Tobias66662/Bachelor-Project-Enose-PCB/Enose_PCB/Enose_PCB.kicad_pcb

## KiCad design Enose_PCB/Enose_PCB.kicad_pcb (2026-04-17)

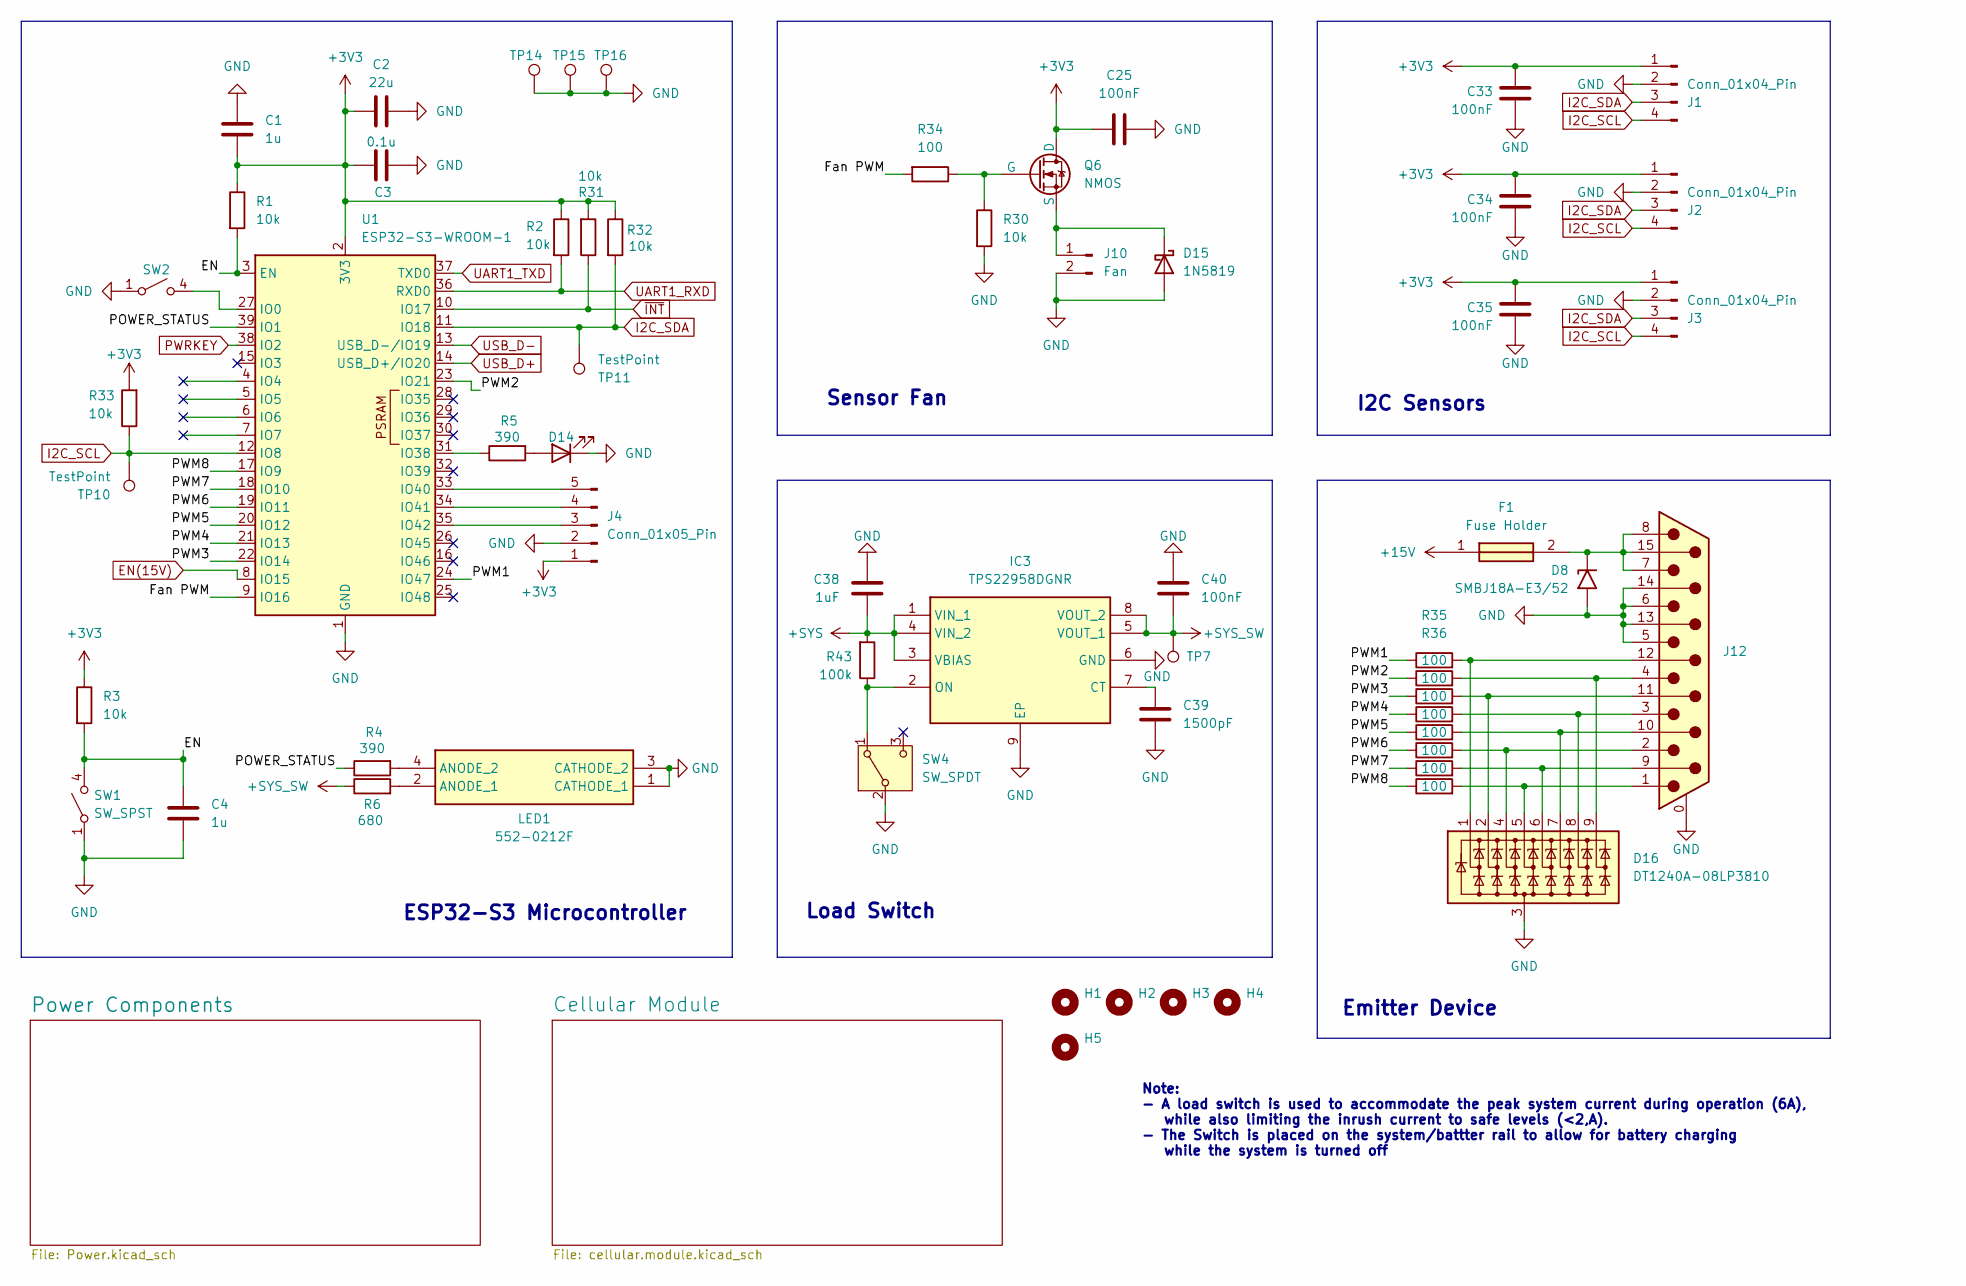
[picture p1: schematic Enose_PCB.kicad_sch]

Parts:
C1, C4: 1u; C_0805_2012Metric_Pad1.18x1.45mm_HandSolder
C2: 22u; C_0805_2012Metric_Pad1.18x1.45mm_HandSolder
C3: 0.1u; C_0805_2012Metric_Pad1.18x1.45mm_HandSolder
C25, C33, C34, C35, C40: 100nF; C_0805_2012Metric_Pad1.18x1.45mm_HandSolder
C38: 1uF; C_0805_2012Metric_Pad1.18x1.45mm_HandSolder
C39: 1500pF; C_0805_2012Metric_Pad1.18x1.45mm_HandSolder
D8: SMBJ18A-E3/52; D_SMB
D14: LED Amber; LED_0805_2012Metric_Pad1.15x1.40mm_HandSolder
D15: 1N5819; D_SOD-123
D16: DT1240A-08LP3810; UDFN-9_1.0x3.8mm_P0.5mm
F1: Fuse Holder; 64600001223; Mouser Part Number 576-64600001223
H1, H2, H3, H4, H5: MountingHole; MountingHole_3.2mm_M3
IC3: TPS22958DGNR; SOP65P490X110-9N; Mouser Part Number 595-TPS22958DGNR
J1: Conn_01x04_Pin; PinHeader_1x04_P2.54mm_Vertical
J2, J3: Conn_01x04_Pin; JST_XH_B4B-XH-A_1x04_P2.50mm_Vertical
J4: Conn_01x05_Pin; PinHeader_1x05_P2.54mm_Vertical
J10: Fan; JST_XH_B2B-XH-AM_1x02_P2.50mm_Vertical
J12: DA15_Pins_MountingHoles; 6E17C015PAJ121
LED1: 552-0212F; 5520212F; Mouser Part Number 645-552-0212F
Q6: NMOS; SOT-23-3
R1, R2, R3, R30, R31, R32, R33: 10k; R_0805_2012Metric_Pad1.20x1.40mm_HandSolder
R4, R5: 390; R_0805_2012Metric_Pad1.20x1.40mm_HandSolder
R6: 680; R_0805_2012Metric_Pad1.20x1.40mm_HandSolder
R34, R35, R36, R37, R38, R39, R40, R41, R42: 100; R_0805_2012Metric_Pad1.20x1.40mm_HandSolder
R43: 100k; R_0805_2012Metric_Pad1.20x1.40mm_HandSolder
SW1, SW2: SW_SPST; 430181038816
SW4: SW_SPDT; OS102011MA1QN1
TP7, TP10, TP11, TP14, TP15, TP16: TestPoint; TestPoint_Pad_D1.5mm
U1: ESP32-S3-WROOM-1

Connections:
+3V3: C1.1, C2.1, C3.2, C25.2, C33.1, C34.1, C35.1, J1.1, J2.1, J3.1, J4.1, Q6.1 (D), R1.1, R2.1, R3.1, R31.2, R32.1, R33.2, U1.2 (3V3); also elsewhere on the board
+15V: F1.1; also elsewhere on the board
+SYS: C38.2, IC3.1 (VIN_1), IC3.3 (VBIAS), IC3.4 (VIN_2), R43.2; also elsewhere on the board
+SYS_SW: C40.2, IC3.5 (VOUT_1), IC3.8 (VOUT_2), R6.1, TP7.1; also elsewhere on the board
/EN: C4.1, R1.2, R3.2, SW1.4 (B), U1.3 (EN)
/Fan PWM: R34.2, U1.9 (IO16)
/POWER_STATUS: R4.1, U1.39 (IO1)
/PWM1: R35.1, U1.24 (IO47)
/PWM2: R36.1, U1.23 (IO21)
/PWM3: R37.1, U1.22 (IO14)
/PWM4: R38.1, U1.21 (IO13)
/PWM5: R39.1, U1.20 (IO12)
/PWM6: R40.1, U1.19 (IO11)
/PWM7: R41.1, U1.18 (IO10)
/PWM8: R42.1, U1.17 (IO9)
EN(15V): U1.8 (IO15); also elsewhere on the board
GND: C1.2, C2.2, C3.1, C4.2, C25.1, C33.2, C34.2, C35.2, C38.1, C39.2, C40.1, D8.2 (A2), D14.1 (K), D15.2 (A), D16.3 (A), IC3.6 (GND), IC3.9 (EP), J1.2, J2.2, J3.2, J4.2, J10.2, J12.0 (PAD), J12.5, J12.6, J12.13, J12.14, LED1.1 (CATHODE_1), LED1.3 (CATHODE_2), R30.2, SW1.1 (A), SW2.1 (A), SW4.2 (B), TP14.1, TP15.1, TP16.1, U1.1 (GND), U1.40 (GND), U1.41 (GND); also elsewhere on the board
I2C_SCL: J1.4, J2.4, J3.4, R33.1, TP10.1, U1.12 (IO8); also elsewhere on the board
I2C_SDA: J1.3, J2.3, J3.3, R32.2, TP11.1, U1.11 (IO18); also elsewhere on the board
unnamed: D8.1 (A1), F1.2, J12.7, J12.8, J12.15
unnamed: D14.2 (A), R5.2
unnamed: D15.1 (K), J10.1, Q6.3 (S)
unnamed: D16.1 (K1), J12.12, R35.2
unnamed: D16.2 (K2), J12.11 (P111), R37.2
unnamed: D16.4 (K3), J12.2, R40.2
unnamed: D16.5 (K4), J12.1, R42.2
unnamed: D16.6 (K5), J12.9, R41.2
unnamed: D16.7 (K6), J12.10, R39.2
unnamed: D16.8 (K7), J12.3, R38.2
unnamed: D16.9 (K8), J12.4, R36.2
unnamed: C39.1, IC3.7 (CT)
unnamed: IC3.2 (ON), R43.1, SW4.1 (A)
unnamed: J4.3, U1.35 (IO42)
unnamed: J4.4, U1.34 (IO41)
unnamed: J4.5, U1.33 (IO40)
unnamed: LED1.2 (ANODE_1), R6.2
unnamed: LED1.4 (ANODE_2), R4.2
unnamed: Q6.2 (G), R30.1, R34.1
unnamed: SW2.4 (B), U1.27 (IO0)
unnamed: R5.1, U1.31 (IO38)
PWRKEY: U1.38 (IO2); also elsewhere on the board
UART1_RXD: R2.2, U1.36 (RXD0); also elsewhere on the board
UART1_TXD: U1.37 (TXD0); also elsewhere on the board
USB_D+: U1.14 (USB_D+/IO20); also elsewhere on the board
USB_D-: U1.13 (USB_D-/IO19); also elsewhere on the board
~INT: R31.1, U1.10 (IO17); also elsewhere on the board

Notes on the sheet:
Note: - A load switch is used to accommodate the peak system current during operation (6A), while also limiting the inrush current to safe levels (<2,A). - The Switch is placed on the system/battter rail to allow for battery charging while the system is turned off
ESP32-S3 Microcontroller
Emitter Device
Load Switch
I2C Sensors
Sensor Fan

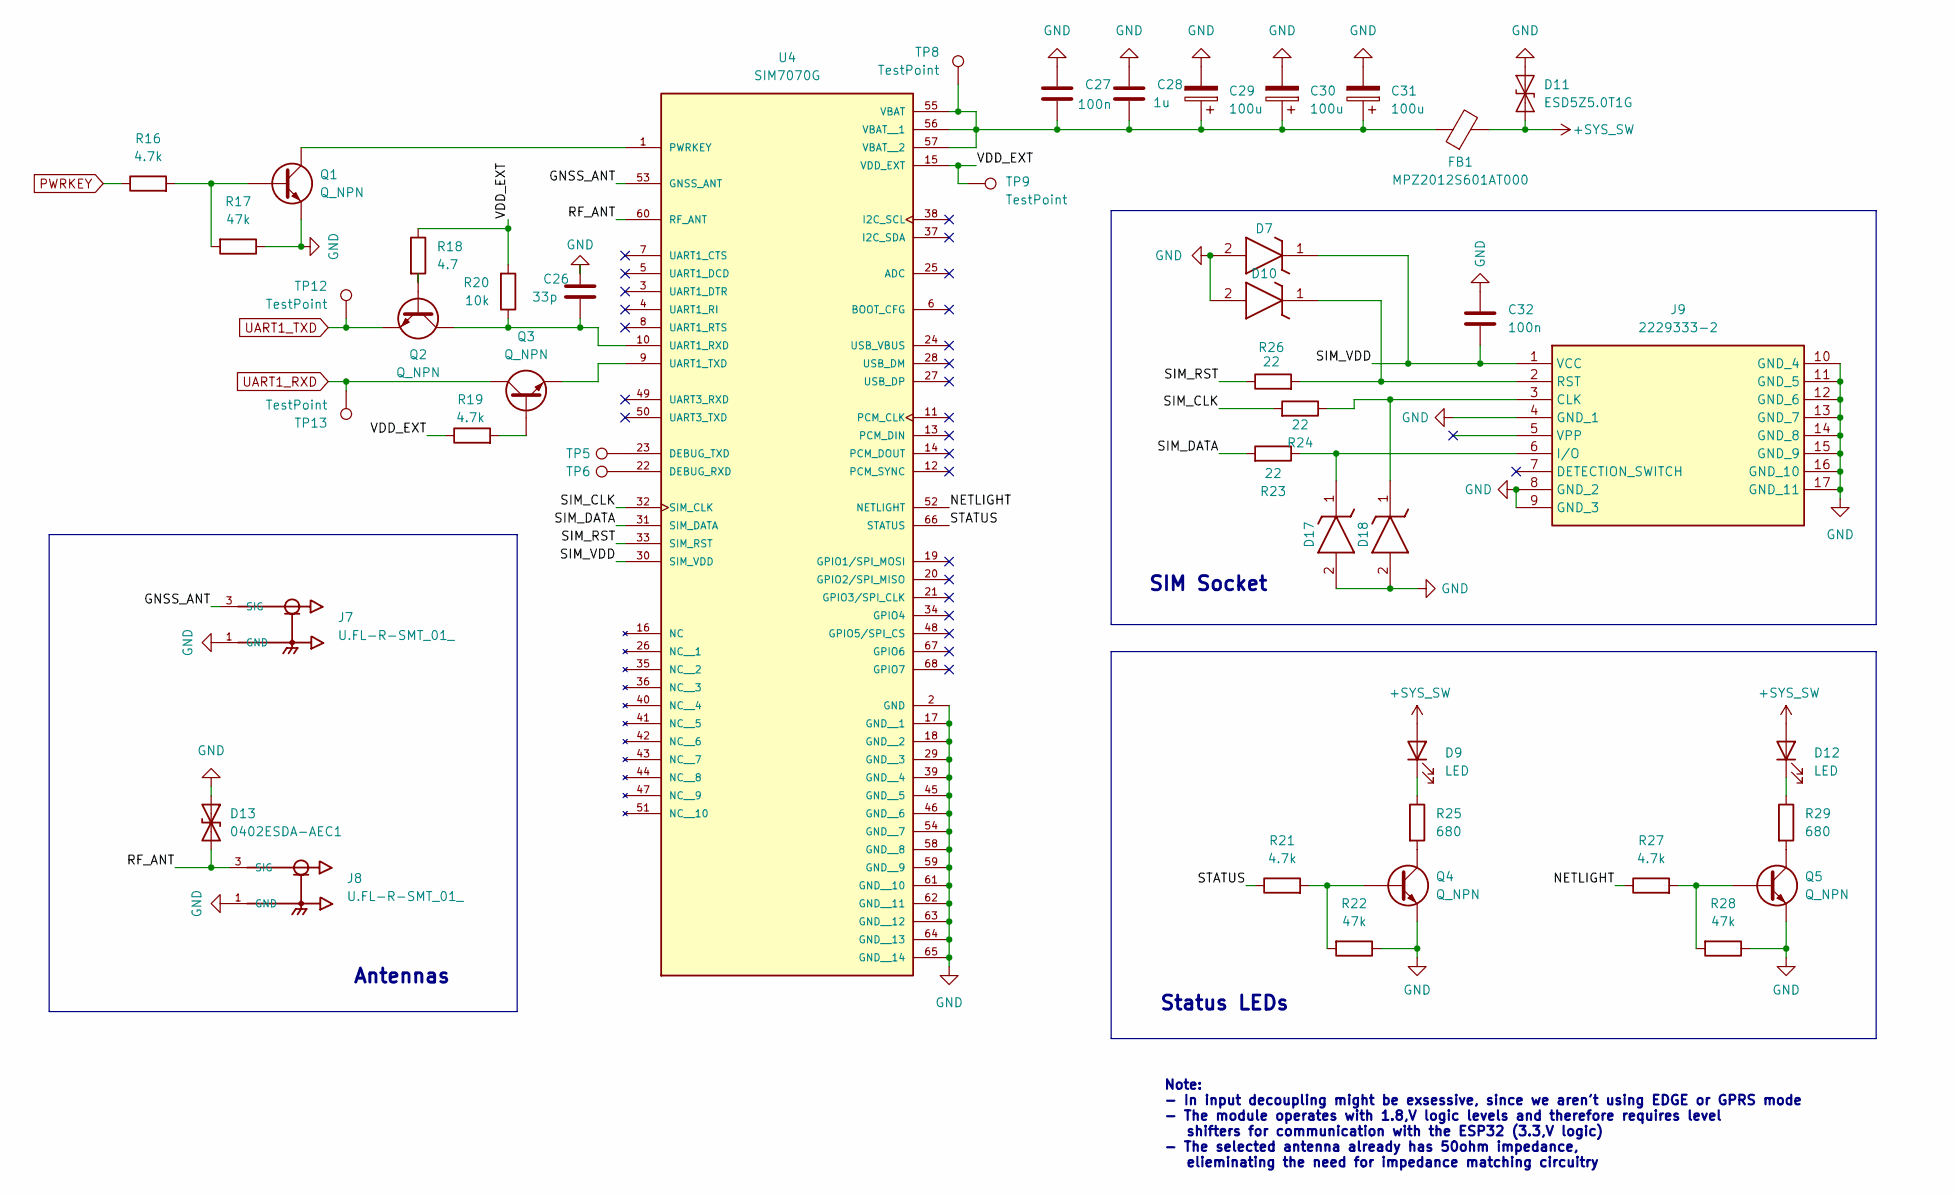
[picture p2: schematic cellular.module.kicad_sch]

Parts:
C26: 33p; C_0603_1608Metric_Pad1.08x0.95mm_HandSolder
C27, C32: 100n; C_0805_2012Metric_Pad1.18x1.45mm_HandSolder
C28: 1u; C_0805_2012Metric_Pad1.18x1.45mm_HandSolder
C29, C30, C31: 100u; CAPAE530X610N
D7, D10, D17, D18: ESD8351XV2T1G; SODFL1608X70N; Mouser Part Number 863-ESD8351XV2T1G
D9, D12: LED; LED_0805_2012Metric_Pad1.15x1.40mm_HandSolder
D11: ESD5Z5.0T1G; D_SOD-523
D13: 0402ESDA-AEC1; 0402ESDAAEC1
FB1: MPZ2012S601AT000; L_0805_2012Metric_Pad1.05x1.20mm_HandSolder
J7, J8: U.FL-R-SMT_01_; HRS_U.FL-R-SMT_01_
J9: 2229333-2; 22293332; Mouser Part Number 571-2229333-2
Q1, Q2, Q3, Q4, Q5: Q_NPN; SOT96P237X111-3N
R16, R19, R21, R27: 4.7k; R_0805_2012Metric_Pad1.20x1.40mm_HandSolder
R17, R22, R28: 47k; R_0805_2012Metric_Pad1.20x1.40mm_HandSolder
R18: 4.7; R_0805_2012Metric_Pad1.20x1.40mm_HandSolder
R20: 10k; R_0805_2012Metric_Pad1.20x1.40mm_HandSolder
R23, R24, R26: 22; R_0805_2012Metric_Pad1.20x1.40mm_HandSolder
R25, R29: 680; R_0805_2012Metric_Pad1.20x1.40mm_HandSolder
TP5, TP6, TP8, TP9, TP12, TP13: TestPoint; TestPoint_Pad_D1.5mm
U4: SIM7070G; MODULE_SIM7070G; PARTREV V1.03

Connections:
+SYS_SW: D9.2 (A), D11.1 (A1), D12.2 (A), FB1.2; also elsewhere on the board
/Cellular Module/GNSS_ANT: J7.3 (SIG), U4.53 (GNSS_ANT)
/Cellular Module/NETLIGHT: R27.1, U4.52 (NETLIGHT)
/Cellular Module/RF_ANT: D13.2 (A2), J8.3 (SIG), U4.60 (RF_ANT)
/Cellular Module/SIM_CLK: R24.2, U4.32 (SIM_CLK)
/Cellular Module/SIM_DATA: R23.2, U4.31 (SIM_DATA)
/Cellular Module/SIM_RST: R26.1, U4.33 (SIM_RST)
/Cellular Module/SIM_VDD: C32.2, D7.1 (K), J9.1 (VCC), U4.30 (SIM_VDD)
/Cellular Module/STATUS: R21.1, U4.66 (STATUS)
/Cellular Module/VDD_EXT: R18.1, R19.1, R20.2, TP9.1, U4.15 (VDD_EXT)
GND: C26.1, C27.1, C28.1, C29.2, C30.2, C31.2, C32.1, D7.2 (A), D10.2 (A), D11.2 (A2), D13.1 (A1), D17.2 (A), D18.2 (A), J7.1 (GND), J7.2 (GND), J8.1 (GND), J8.2 (GND), J9.4 (GND_1), J9.8 (GND_2), J9.9 (GND_3), J9.10 (GND_4), J9.11 (GND_5), J9.12 (GND_6), J9.13 (GND_7), J9.14 (GND_8), J9.15 (GND_9), J9.16 (GND_10), J9.17 (GND_11), Q1.2 (E), Q4.2 (E), Q5.2 (E), R17.1, R22.1, R28.1, U4.2 (GND), U4.17 (GND__1), U4.18 (GND__2), U4.29 (GND__3), U4.39 (GND__4), U4.45 (GND__5), U4.46 (GND__6), U4.54 (GND__7), U4.58 (GND__8), U4.59 (GND__9), U4.61 (GND__10), U4.62 (GND__11), U4.63 (GND__12), U4.64 (GND__13), U4.65 (GND__14); also elsewhere on the board
unnamed: D9.1 (K), R25.1
unnamed: D10.1 (K), J9.2 (RST), R26.2
unnamed: D12.1 (K), R29.1
unnamed: D17.1 (K), J9.6 (I/O), R23.1
unnamed: D18.1 (K), J9.3 (CLK), R24.1
unnamed: Q1.1 (B), R16.2, R17.2
unnamed: Q1.3 (C), U4.1 (PWRKEY)
unnamed: Q2.1 (B), R18.2
unnamed: C26.2, Q2.3 (C), R20.1, U4.10 (UART1_RXD)
unnamed: Q3.1 (B), R19.2
unnamed: Q3.2 (E), U4.9 (UART1_TXD)
unnamed: Q4.1 (B), R21.2, R22.2
unnamed: Q4.3 (C), R25.2
unnamed: Q5.1 (B), R27.2, R28.2
unnamed: Q5.3 (C), R29.2
unnamed: TP6.1, U4.22 (DEBUG_RXD)
unnamed: TP5.1, U4.23 (DEBUG_TXD)
unnamed: C27.2, C28.2, C29.1, C30.1, C31.1, FB1.1, TP8.1, U4.55 (VBAT), U4.56 (VBAT__1), U4.57 (VBAT__2)
PWRKEY: R16.1; also elsewhere on the board
UART1_RXD: Q3.3 (C), TP13.1; also elsewhere on the board
UART1_TXD: Q2.2 (E), TP12.1; also elsewhere on the board

Notes on the sheet:
SIM Socket
Status LEDs
Antennas
Note: - In input decoupling might be exsessive, since we aren't using EDGE or GPRS mode - The module operates with 1.8,V logic levels and therefore requires level shifters for communication with the ESP32 (3.3,V logic) - The selected antenna already has 50ohm impedance, elieminating the need for im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

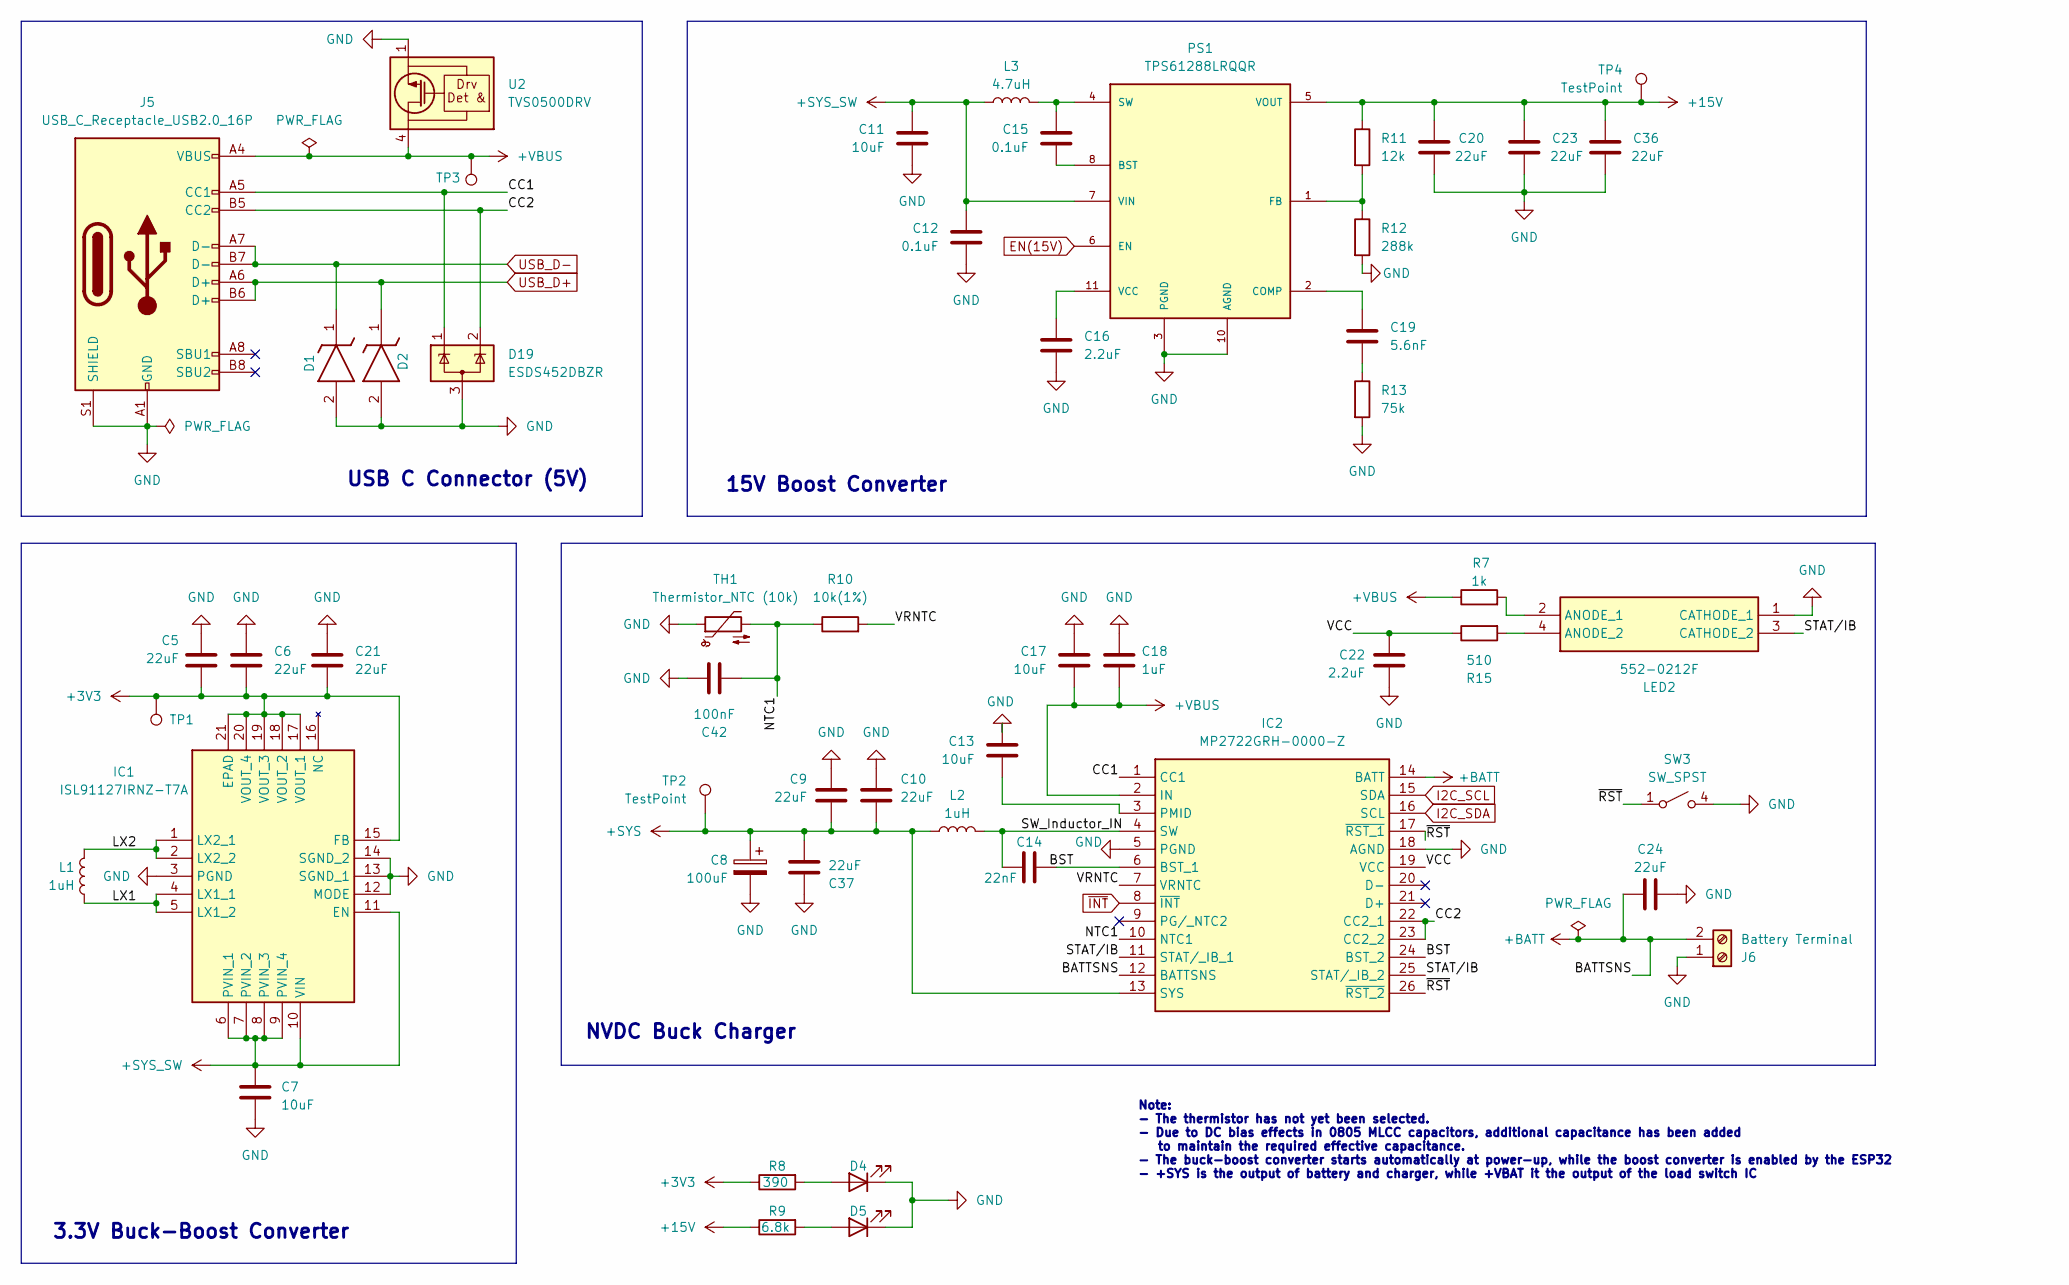
[picture p3: schematic Power.kicad_sch]

Parts:
C5, C6, C9, C10, C21, C24, C37: 22uF; C_0805_2012Metric_Pad1.18x1.45mm_HandSolder
C7, C11, C13, C17: 10uF; C_0805_2012Metric_Pad1.18x1.45mm_HandSolder
C8: 100uF; CAPAE530X610N
C12, C15: 0.1uF; C_0805_2012Metric_Pad1.18x1.45mm_HandSolder
C14: 22nF; C_0805_2012Metric_Pad1.18x1.45mm_HandSolder
C16, C22: 2.2uF; C_0805_2012Metric_Pad1.18x1.45mm_HandSolder
C18: 1uF; C_0805_2012Metric_Pad1.18x1.45mm_HandSolder
C19: 5.6nF; C_0805_2012Metric_Pad1.18x1.45mm_HandSolder
C20, C23, C36: 22uF; C_1210_3225Metric_Pad1.33x2.70mm_HandSolder
C42: 100nF; C_0805_2012Metric_Pad1.18x1.45mm_HandSolder
D1, D2: ESD8351XV2T1G; SODFL1608X70N; Mouser Part Number 863-ESD8351XV2T1G
D4, D5: LED GREEN; LED_0805_2012Metric_Pad1.15x1.40mm_HandSolder
D19: ESDS452DBZR; SOT-23-3
IC1: ISL91127IRNZ-T7A; QFN50P400X400X100-21N; Manufacturer_Part_Number ISL91127IRNZ-T7A; Mouser Part Number 968-ISL91127IRNZ-T7A
IC2: MP2722GRH-0000-Z; MP2722GRH0000Z; Mouser Part Number 946-MP2722GRH-0000-Z
J5: USB_C_Receptacle_USB2.0_16P; USB_C_Receptacle_GCT_USB4105-xx-A_16P_TopMnt_Horizontal
J6: Battery Terminal; TerminalBlock_Phoenix_PT-1,5-2-3.5-H_1x02_P3.50mm_Horizontal
L1: 1uH; SRP4030FA1R0M
L2: 1uH; INDPM5355X310N
L3: 4.7uH; L_Coilcraft_XAL6060-XXX
LED2: 552-0212F; 5520212F; Mouser Part Number 645-552-0212F
PS1: TPS61288LRQQR; CONV_TPS61288LRQQR; PARTREV C
R7: 1k; R_0805_2012Metric_Pad1.20x1.40mm_HandSolder
R8: 390; R_0805_2012Metric_Pad1.20x1.40mm_HandSolder
R9: 6.8k; R_0805_2012Metric_Pad1.20x1.40mm_HandSolder
R10: 10k(1%); R_0805_2012Metric_Pad1.20x1.40mm_HandSolder
R11: 12k; R_0805_2012Metric_Pad1.20x1.40mm_HandSolder
R12: 288k; R_0805_2012Metric_Pad1.20x1.40mm_HandSolder
R13: 75k; R_0805_2012Metric_Pad1.20x1.40mm_HandSolder
R15: 510; R_0805_2012Metric_Pad1.20x1.40mm_HandSolder
SW3: SW_SPST; 430181038816
TH1: Thermistor_NTC (10k); JST_XH_B2B-XH-AM_1x02_P2.50mm_Vertical
TP1, TP2, TP3, TP4: TestPoint; TestPoint_Pad_D1.5mm
U2: TVS0500DRV; WSON-6-1EP_2x2mm_P0.65mm_EP1x1.6mm

Connections:
+3V3: C5.2, C6.2, C21.2, IC1.15 (FB), IC1.17 (VOUT_1), IC1.18 (VOUT_2), IC1.19 (VOUT_3), IC1.20 (VOUT_4), IC1.21 (EPAD), R8.1, TP1.1; also elsewhere on the board
+15V: C20.1, C23.1, C36.1, PS1.5 (VOUT), R9.1, R11.1, TP4.1; also elsewhere on the board
+BATT: C24.2, IC2.12 (BATTSNS), IC2.14 (BATT), J6.2
+SYS: C8.1, C9.1, C10.2, C37.1, IC2.13 (SYS), L2.1, TP2.1; also elsewhere on the board
+SYS_SW: C7.1, C11.1, C12.1, IC1.6 (PVIN_1), IC1.7 (PVIN_2), IC1.8 (PVIN_3), IC1.9 (PVIN_4), IC1.10 (VIN), IC1.11 (EN), L3.1, PS1.7 (VIN); also elsewhere on the board
+VBUS: C17.1, C18.2, IC2.2 (IN), J5.A4 (VBUS), J5.A9 (VBUS), J5.B4 (VBUS), J5.B9 (VBUS), R7.1, TP3.1, U2.4 (IN), U2.5 (IN), U2.6 (IN)
/Power Components/BST: C14.2, IC2.6 (BST_1), IC2.24 (BST_2)
/Power Components/CC1: D19.1 (K), IC2.1 (CC1), J5.A5 (CC1)
/Power Components/CC2: D19.2 (K), IC2.22 (CC2_1), IC2.23 (CC2_2), J5.B5 (CC2)
/Power Components/LX1: IC1.4 (LX1_1), IC1.5 (LX1_2), L1.2
/Power Components/LX2: IC1.1 (LX2_1), IC1.2 (LX2_2), L1.1
/Power Components/NTC1: C42.2, IC2.10 (NTC1), R10.1, TH1.2
/Power Components/STAT/IB: IC2.11 (STAT/_IB_1), IC2.25 (STAT/_IB_2), LED2.3 (CATHODE_2)
/Power Components/SW_Inductor_IN: C14.1, IC2.4 (SW), L2.2
/Power Components/VCC: C22.1, IC2.19 (VCC), R15.1
/Power Components/VRNTC: IC2.7 (VRNTC), R10.2
/Power Components/~RST: IC2.17 (~RST_1), IC2.26 (~RST_2), SW3.1 (A)
EN(15V): PS1.6 (EN); also elsewhere on the board
GND: C5.1, C6.1, C7.2, C8.2, C9.2, C10.1, C11.2, C12.2, C13.2, C16.2, C17.2, C18.1, C20.2, C21.1, C22.2, C23.2, C24.1, C36.2, C37.2, C42.1, D1.2 (A), D2.2 (A), D4.1 (K), D5.1 (K), D19.3 (A), IC1.3 (PGND), IC1.12 (MODE), IC1.13 (SGND_1), IC1.14 (SGND_2), IC2.5 (PGND), IC2.18 (AGND), J5.A1 (GND), J5.A12 (GND), J5.B1 (GND), J5.B12 (GND), J5.S1 (SHIELD), J6.1, LED2.1 (CATHODE_1), PS1.3 (PGND), PS1.10 (AGND), R12.2, R13.2, SW3.4 (B), TH1.1, U2.1 (GND), U2.2 (GND), U2.3 (GND), U2.7 (GND); also elsewhere on the board
I2C_SCL: IC2.15 (SDA); also elsewhere on the board
I2C_SDA: IC2.16 (SCL); also elsewhere on the board
unnamed: C15.1, L3.2, PS1.4 (SW), PS1.9 (SW)
unnamed: C19.2, R13.1
unnamed: D4.2 (A), R8.2
unnamed: D5.2 (A), R9.2
unnamed: C13.1, IC2.3 (PMID)
unnamed: LED2.2 (ANODE_1), R7.2
unnamed: LED2.4 (ANODE_2), R15.2
unnamed: C15.2, PS1.8 (BST)
unnamed: C19.1, PS1.2 (COMP)
unnamed: PS1.1 (FB), R11.2, R12.1
unnamed: C16.1, PS1.11 (VCC)
USB_D+: D2.1 (K), J5.A6 (D+), J5.B6 (D+); also elsewhere on the board
USB_D-: D1.1 (K), J5.A7 (D-), J5.B7 (D-); also elsewhere on the board
~INT: IC2.8 (~INT); also elsewhere on the board

Notes on the sheet:
15V Boost Converter
3.3V Buck-Boost Converter
Note: - The thermistor has not yet been selected. - Due to DC bias effects in 0805 MLCC capacitors, additional capacitance has been added to maintain the required effective capacitance. - The buck-boost converter starts automatically at power-up, while the boost converter is enabled by the ESP32 - 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
USB C Connector (5V)
NVDC Buck Charger

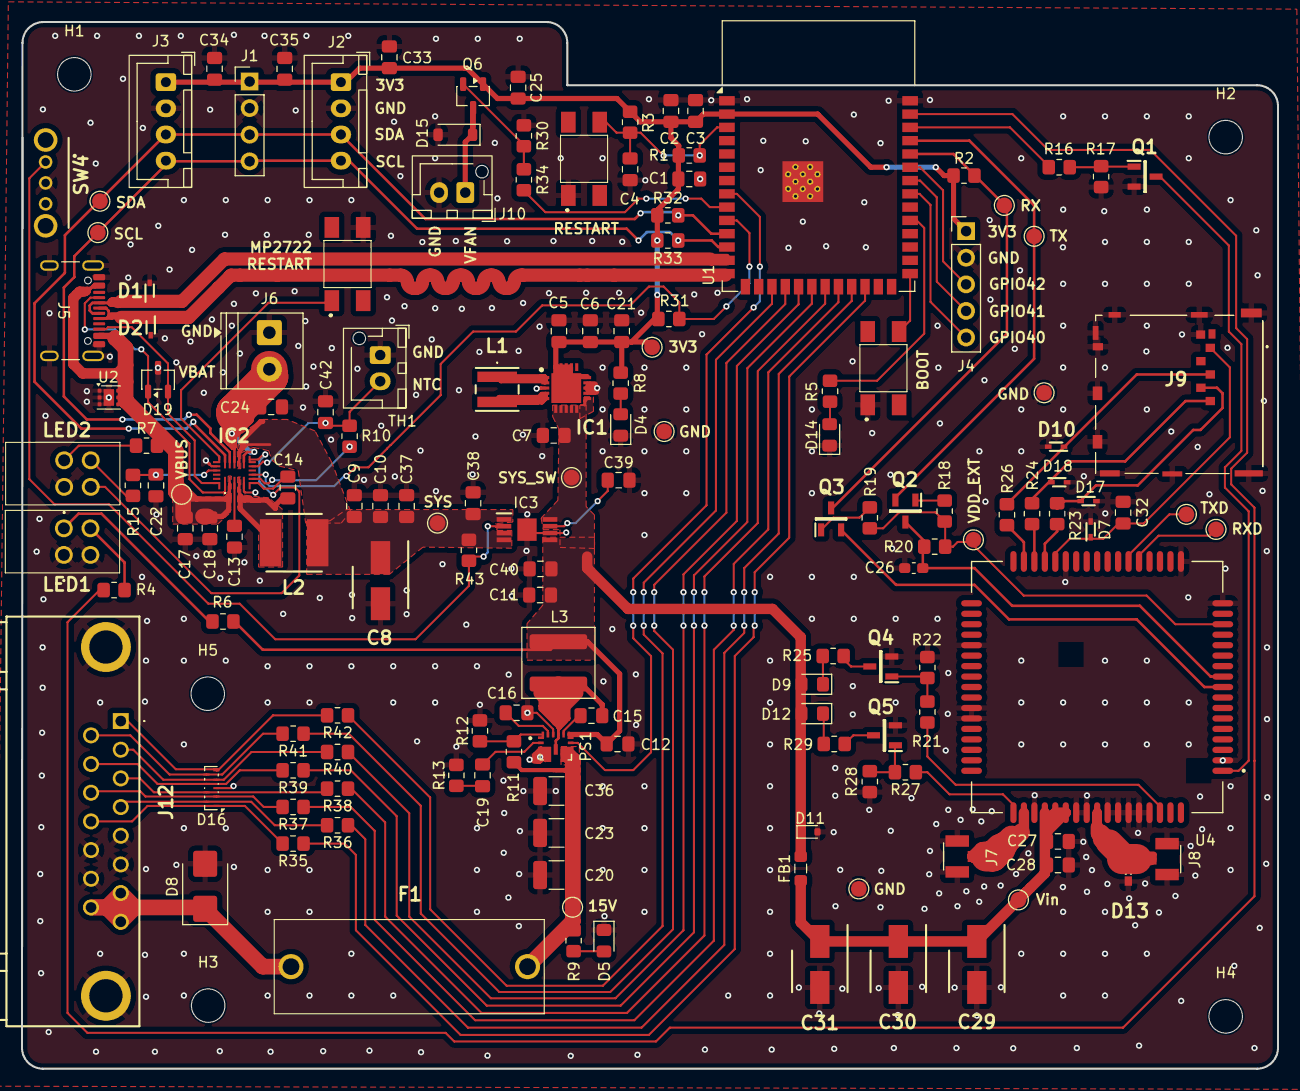
[picture p4: board Enose_PCB.kicad_pcb from above]

Board: 2 copper layers, 120.0 x 100.0 mm, 157 parts (0 on the bottom side), 97 nets.
