Tobias66662/Bachelor-Project-Enose-PCB/(commit log)

2026-03-03 added some connectors
    [Enose_PCB.kicad_sch, Power.kicad_sch]
2026-03-04 adding my pcb to the repo
    [Enose_PCB.kicad_pcb, Enose_PCB.kicad_sch, Multi-emitter V2 Thesis.kicad_pcb, Multi-emitter V2 Thesis.kicad_sch, Power.kicad_sch, cellular.module.kicad_sch]
2026-03-04 testing comment change on pcb to play with git pushing
    [Multi-emitter V2 Thesis.kicad_sch]
2026-03-06 pushing some changes only a bit to go
    [Multi-emitter V2 Thesis.kicad_sch]
2026-03-19 Changed power symbols
    [Enose_PCB.kicad_sch, Power.kicad_sch, cellular.module.kicad_sch]
2026-03-20 Added something idk
    [Power.kicad_sch]
2026-03-20 last emitter pcb changes
2026-04-04 Working on Enose PCB Layout
    [Enose_PCB.kicad_pcb, Enose_PCB.kicad_sch, Power.kicad_sch, cellular.module.kicad_sch]
2026-04-05 Finished placeing components for Enose PCB
    [Enose_PCB.kicad_pcb, Enose_PCB.kicad_sch]
2026-04-07 Added so netlabels
    [Enose_PCB.kicad_pcb, cellular.module.kicad_sch]
2026-04-09 Enose PCB almost done
    [Enose_PCB.kicad_sch, Enose_PCB_2_Layer.kicad_pcb, Power.kicad_sch, cellular.module.kicad_sch]
2026-04-09 PCB almost done
    [Enose_PCB_2_Layer.kicad_pcb]
2026-04-12 Enose PCB almost done, just needs ground vias
    [Enose_PCB.kicad_pcb, Enose_PCB.kicad_sch, Power.kicad_sch, cellular.module.kicad_sch]
2026-04-14 Enose board ready for review
    [Enose_PCB.kicad_pcb, Enose_PCB.kicad_sch, Power.kicad_sch]
2026-04-17 Enose PCB finished
    [Enose_PCB.kicad_pcb, Power.kicad_sch]
